adafruit/Adafruit-MCP9601-PCB/Adafruit MCP9601.brd

## EAGLE design Adafruit MCP9601.brd (2021-08-16)

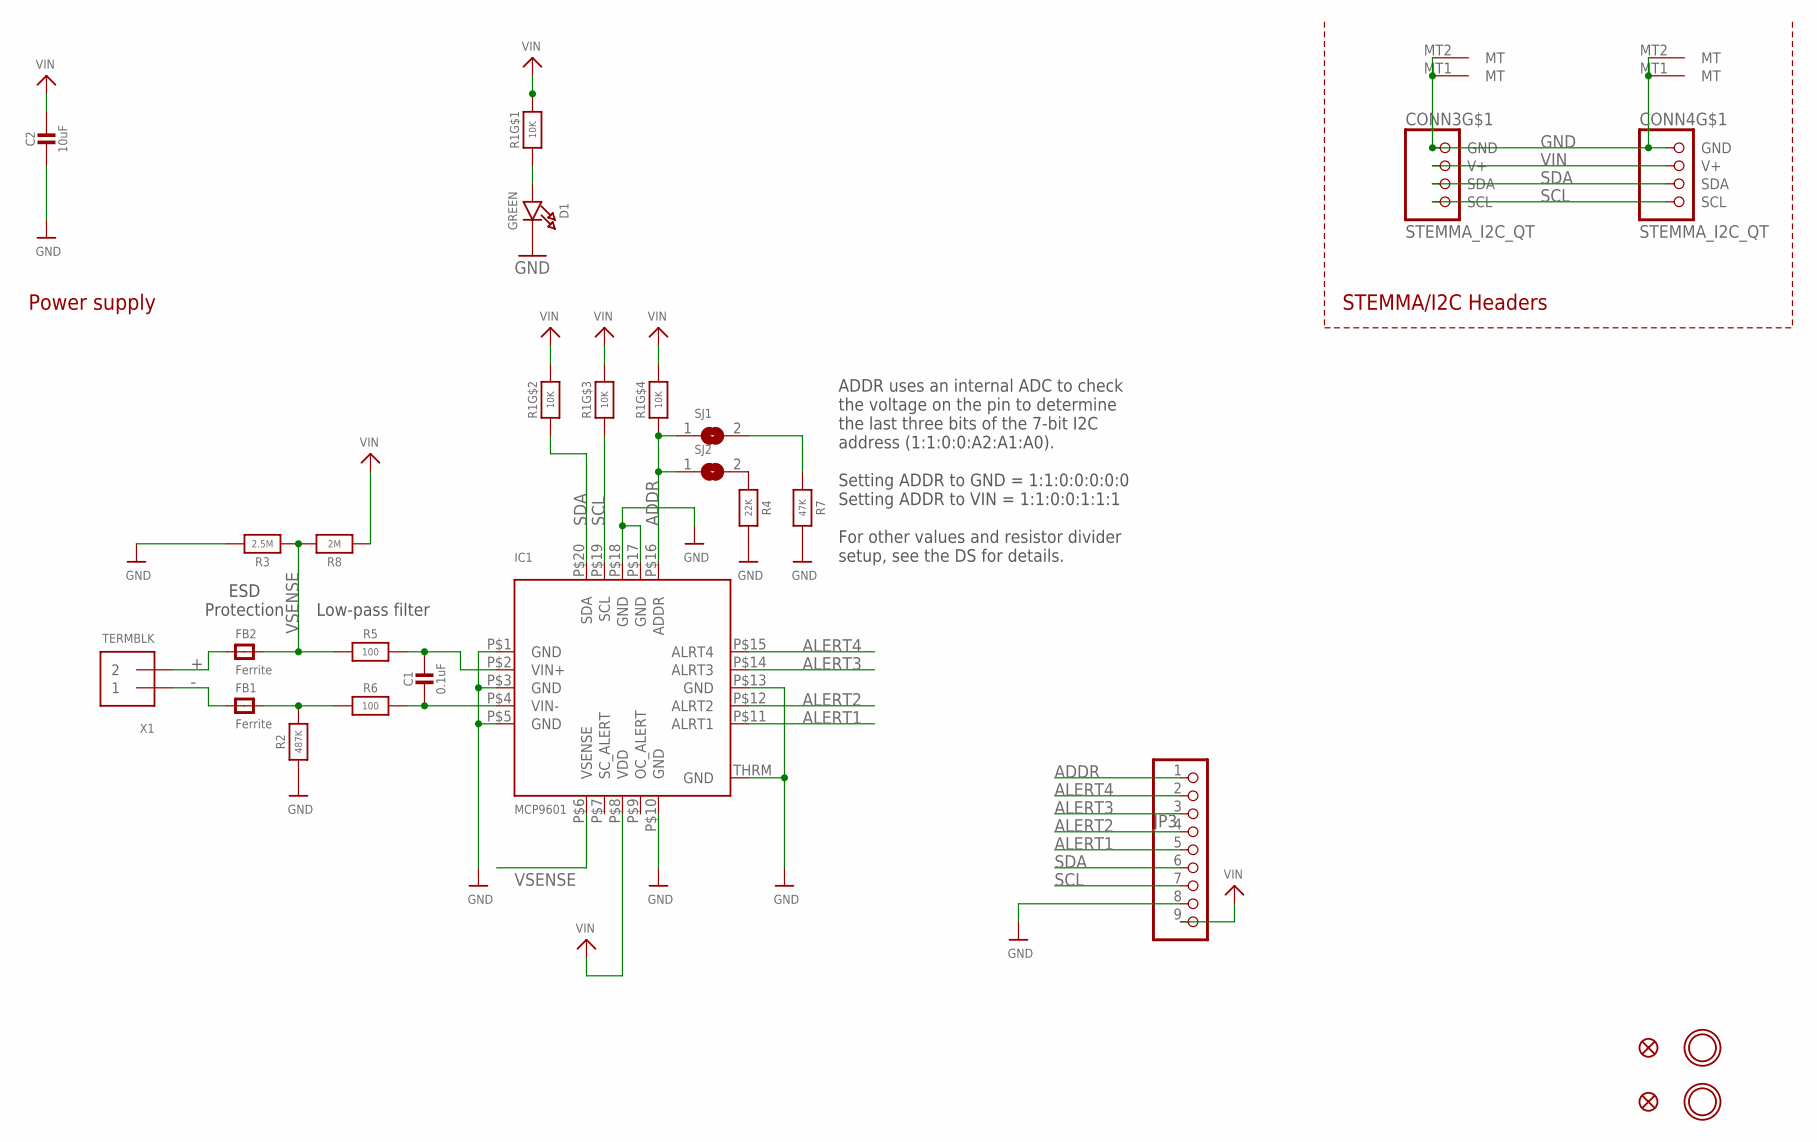
[picture p2: schematic Adafruit MCP9601.sch]

Parts:
C1: 0.1uF; 0603-NO
C2: 10uF; 0805-NO
CONN3, CONN4: STEMMA_I2C_QT; JST_SH4
D1: GREEN; CHIPLED_0603_NOOUTLINE
FB1, FB2: Ferrite; 0603-NO
FID3, FID4: FIDUCIAL_1MM
IC1: MCP9601; VQFN20_5MM
JP3: HEADER-1X970MIL; 1X09_ROUND_70
R1: 10K; RESPACK_4X0603
R2: 487K; 0603-NO
R3: 2.5M; 0603-NO
R4: 22K; 0603-NO
R5, R6: 100; 0603-NO
R7: 47K; 0603-NO
R8: 2M; 0603-NO
SJ1, SJ2: SOLDERJUMPER; SOLDERJUMPER_ARROW_NOPASTE
U$33, U$34: MOUNTINGHOLE2.5; MOUNTINGHOLE_2.5_PLATED
X1: TERMBLK; TERMBLOCK_1X2-3.5MM

Connections:
+: FB2.1, X1.2
-: FB1.1, X1.1
ADDR: IC1.P$16 (ADDR), JP3.1, R1.4 (1), SJ1.1, SJ2.1
ALERT1: IC1.P$11 (ALRT1), JP3.5
ALERT2: IC1.P$12 (ALRT2), JP3.4
ALERT3: IC1.P$14 (ALRT3), JP3.3
ALERT4: IC1.P$15 (ALRT4), JP3.2
GND: C2.2, CONN3.1 (GND), CONN3.MT1 (MT), CONN3.MT2 (MT), CONN4.1 (GND), CONN4.MT1 (MT), CONN4.MT2 (MT), D1.C, IC1.P$1 (GND), IC1.P$3 (GND), IC1.P$5 (GND), IC1.P$10 (GND), IC1.P$13 (GND), IC1.P$17 (GND), IC1.P$18 (GND), IC1.THRM (GND), JP3.8, R2.1, R3.2, R4.2, R7.2
unnamed: C1.1, IC1.P$2 (VIN+), R5.2
unnamed: D1.A, R1.1
unnamed: C1.2, IC1.P$4 (VIN-), R6.2
unnamed: FB1.2, R2.2, R6.1
unnamed: R7.1, SJ1.2
unnamed: R4.1, SJ2.2
SCL: CONN3.4 (SCL), CONN4.4 (SCL), IC1.P$19 (SCL), JP3.7, R1.3 (1)
SDA: CONN3.3 (SDA), CONN4.3 (SDA), IC1.P$20 (SDA), JP3.6, R1.2 (1)
VIN: C2.1, CONN3.2 (V+), CONN4.2 (V+), IC1.P$8 (VDD), JP3.9, R1.5 (2), R1.6 (2), R1.7 (2), R1.8 (2), R8.1
VSENSE: FB2.2, IC1.P$6 (VSENSE), R3.1, R5.1, R8.2

Notes on the sheet:
STEMMA/I2C Headers
Power supply
ADDR uses an internal ADC to check the voltage on the pin to determine the last three bits of the 7-bit I2C address (1:1:0:0:A2:A1:A0). Setting ADDR to GND = 1:1:0:0:0:0:0 Setting ADDR to VIN = 1:1:0:0:1:1:1 For other values and resistor divider setup, see the DS for details.
Low-pass filter
ESD Protection

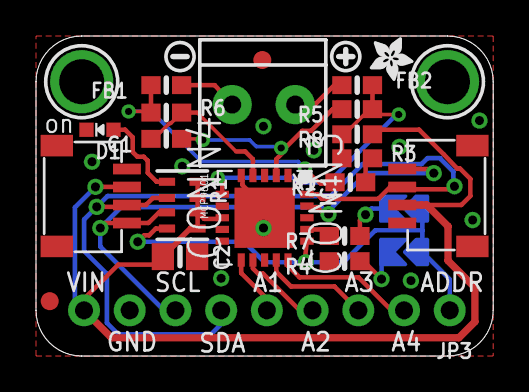
[picture p3: board Adafruit MCP9601.brd from above]

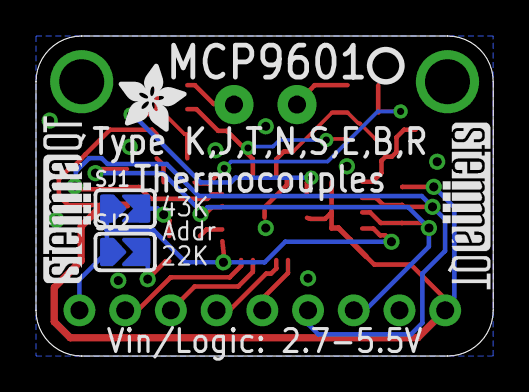
[picture p4: board Adafruit MCP9601.brd from below]

Board: 2 copper layers, 25.4 x 17.8 mm, 31 parts (6 on the bottom side), 18 nets.

Other parts of the board:
U$16: ADAFRUIT_2.5MM
U$17: SYMBOL_PLUS
U$18: SYMBOL_MINUS
U$20: ADAFRUIT_3.5MM
U$40: PCBFEAT-REV-040
U$41, U$42: STEMMAQT
